Kbij/homecontrol/Arduino/Sensor/Doc/DigiMesh update.docx

DigiMesh update:

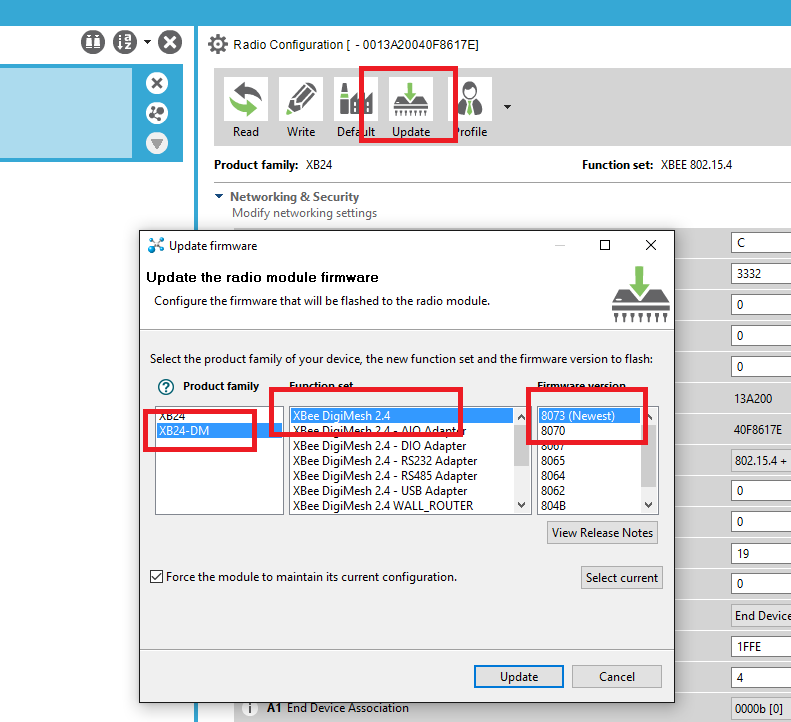
[picture p1: figure]

Write “XBee-DM_ArduinoProfile” profile with XCTU tools
