Kbij/homecontrol/(list of files, cad)

Other CAD files:
Arduino/PCB/Board.skp
Arduino/PCB/MainBoard/Mainboard.skp
Arduino/PCB/TempSensor/Sensor3D.skp
Arduino/PCB/moerhouder.skp
