Kbij/homecontrol/Server/HomeControlTest/testdata/LivingTemperatuur.csv

idTemperature | idSensor | date | temperature
50336 | 2 | 21:49:01 | 23,56
50337 | 2 | 21:49:32 | 23,56
50338 | 2 | 21:50:03 | 23,63
50339 | 2 | 21:50:34 | 23,63
50340 | 2 | 21:51:04 | 23,63
50341 | 2 | 21:53:08 | 23,63
50342 | 2 | 21:56:44 | 23,69
50343 | 2 | 21:57:15 | 23,69
50344 | 2 | 21:58:16 | 23,75
50345 | 2 | 22:07:31 | 23,81
50346 | 2 | 22:08:02 | 23,81
50347 | 2 | 22:08:33 | 23,81
50348 | 2 | 22:09:04 | 23,81
50349 | 2 | 22:09:35 | 23,81
50350 | 2 | 22:10:05 | 23,81
50351 | 2 | 22:10:36 | 23,81
50352 | 2 | 22:11:38 | 23,81
50353 | 2 | 22:12:09 | 23,81
50354 | 2 | 22:12:40 | 23,81
50355 | 2 | 22:13:11 | 23,81
50356 | 2 | 22:13:41 | 23,81
50357 | 2 | 22:14:12 | 23,81
50358 | 2 | 22:14:43 | 23,81
50359 | 2 | 22:15:14 | 23,81
50360 | 2 | 22:15:45 | 23,81
50361 | 2 | 22:16:16 | 23,81
50362 | 2 | 22:16:47 | 23,81
50363 | 2 | 22:17:17 | 23,81
50364 | 2 | 22:17:48 | 23,81
50365 | 2 | 22:18:19 | 23,81
50366 | 2 | 22:25:30 | 23,88
50367 | 2 | 22:26:32 | 23,81
50368 | 2 | 22:27:03 | 23,88
50369 | 2 | 22:27:34 | 23,88
50370 | 2 | 22:29:37 | 23,88
50371 | 2 | 22:30:38 | 23,88
50372 | 2 | 22:31:09 | 23,88
50373 | 2 | 22:31:40 | 23,88
50374 | 2 | 22:42:57 | 23,88
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
