Kbij/homecontrol/Server/HomeControlTest/testdata/LivingTemperatuur2.csv

idTempTemperatures | date | temp
1 | 23:14:23 | 24,13
2 | 23:14:54 | 24
3 | 23:15:25 | 24
4 | 23:15:56 | 24
5 | 23:16:26 | 23,94
6 | 23:16:57 | 23,94
7 | 23:17:28 | 24
8 | 23:17:59 | 24,06
9 | 23:18:30 | 24,13
10 | 23:19:00 | 24,06
11 | 23:19:31 | 24
12 | 23:20:02 | 24
13 | 23:20:33 | 24
14 | 23:21:04 | 23,94
15 | 23:21:34 | 24,06
16 | 23:22:05 | 24
17 | 23:22:36 | 24,06
18 | 23:23:07 | 24
19 | 23:23:38 | 24
20 | 23:24:08 | 24,06
21 | 23:24:39 | 24,06
22 | 23:25:10 | 24
23 | 23:25:41 | 24
24 | 23:26:12 | 24,06
25 | 23:26:42 | 24
26 | 23:27:13 | 24,13
27 | 23:27:44 | 24,06
28 | 23:28:15 | 24
29 | 23:28:46 | 24,13
30 | 23:29:16 | 24,13
31 | 23:29:47 | 24
32 | 23:30:18 | 24,06
33 | 23:30:49 | 24,06
34 | 23:31:20 | 24,13
35 | 23:31:50 | 24,13
36 | 23:32:21 | 24,13
37 | 23:32:52 | 24,06
38 | 23:33:23 | 24
39 | 23:33:54 | 24,13
40 | 23:34:24 | 24,13
41 | 23:34:55 | 24,13
42 | 23:35:26 | 24,06
43 | 23:35:57 | 24,19
44 | 23:36:28 | 24,19
45 | 23:36:58 | 24,13
46 | 23:37:29 | 24,13
47 | 23:38:00 | 24,13
48 | 23:38:31 | 24,19
49 | 23:39:02 | 24,19
50 | 23:39:32 | 24,25
51 | 23:40:03 | 24,13
52 | 23:40:34 | 24,13
53 | 23:41:05 | 24,19
54 | 23:41:36 | 24,19
55 | 23:42:07 | 24,19
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
