Kbij/homecontrol/Arduino/Sensor/Doc/arduino_WirelessShield_Proto_v3-schematic.pdf

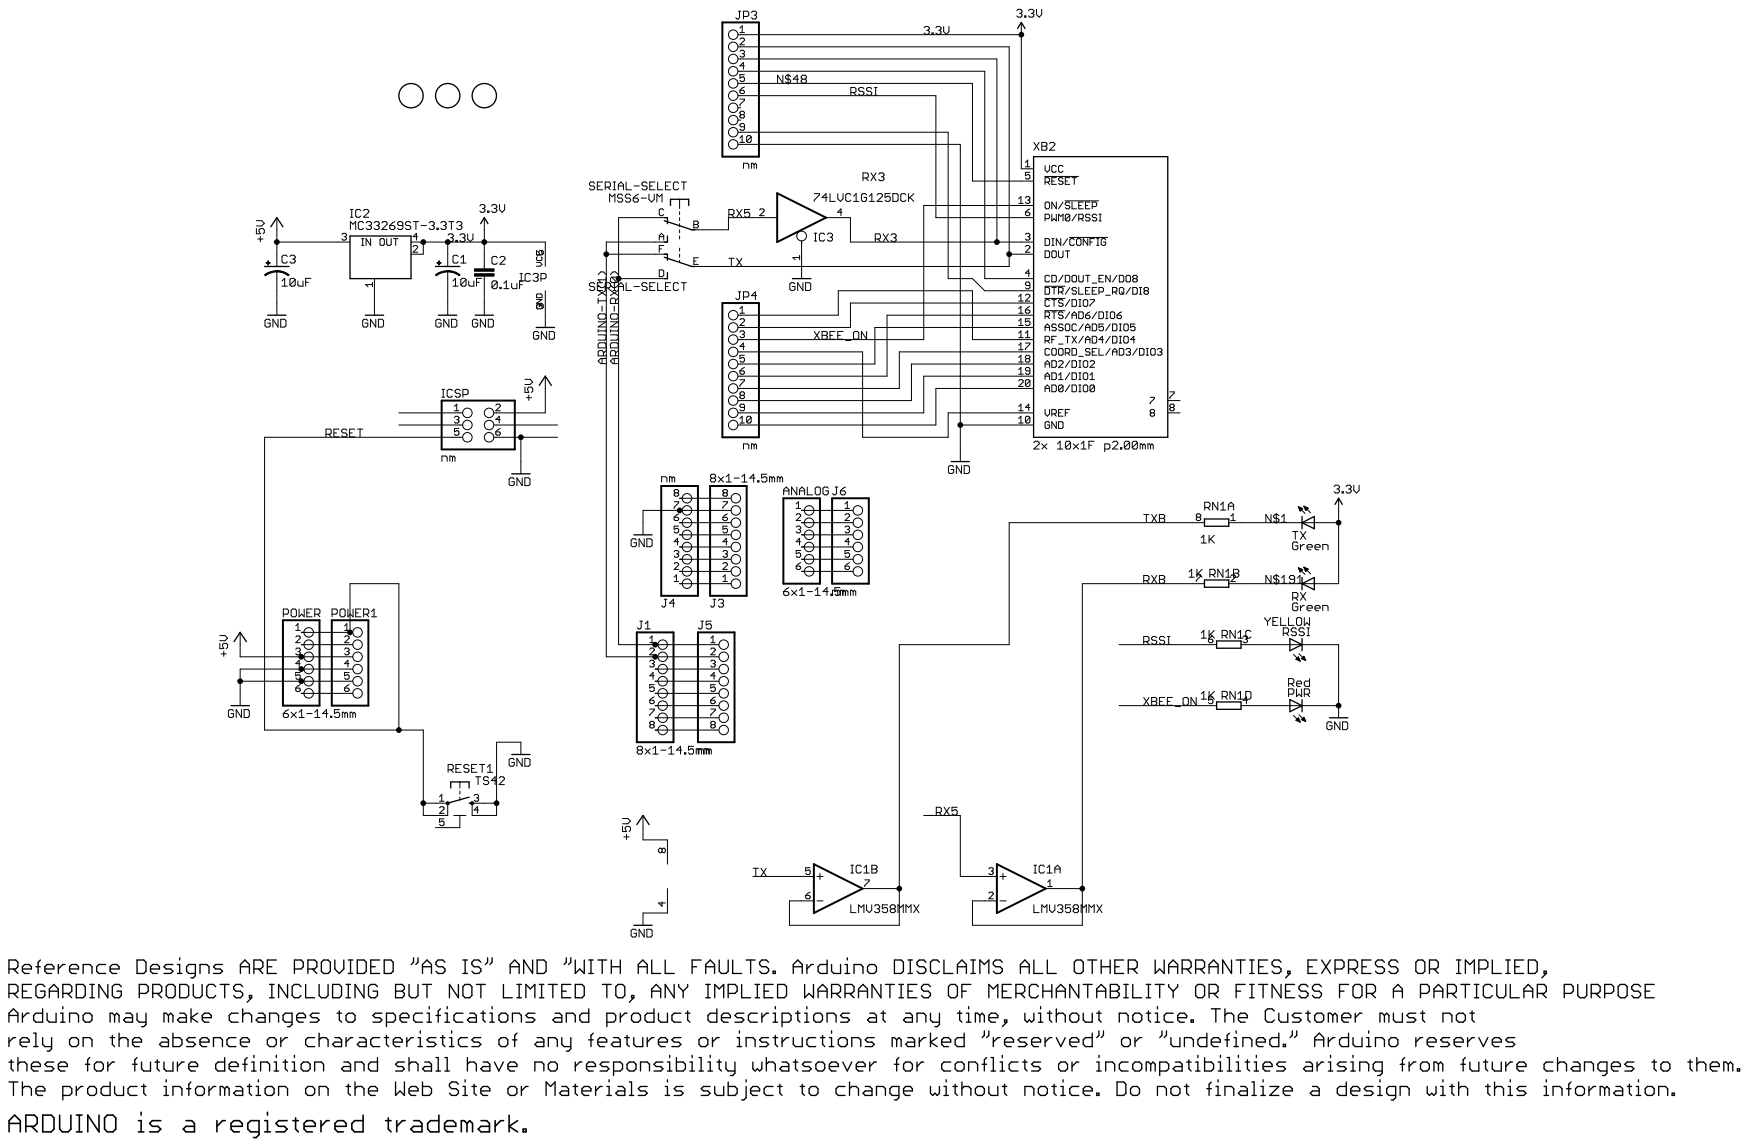
[picture p2: page 1]
