Kbij/homecontrol/Arduino/PCB/MainBoard/Mainboard.brd

## EAGLE design Arduino/PCB/MainBoard/Mainboard.brd (2018-04-23)

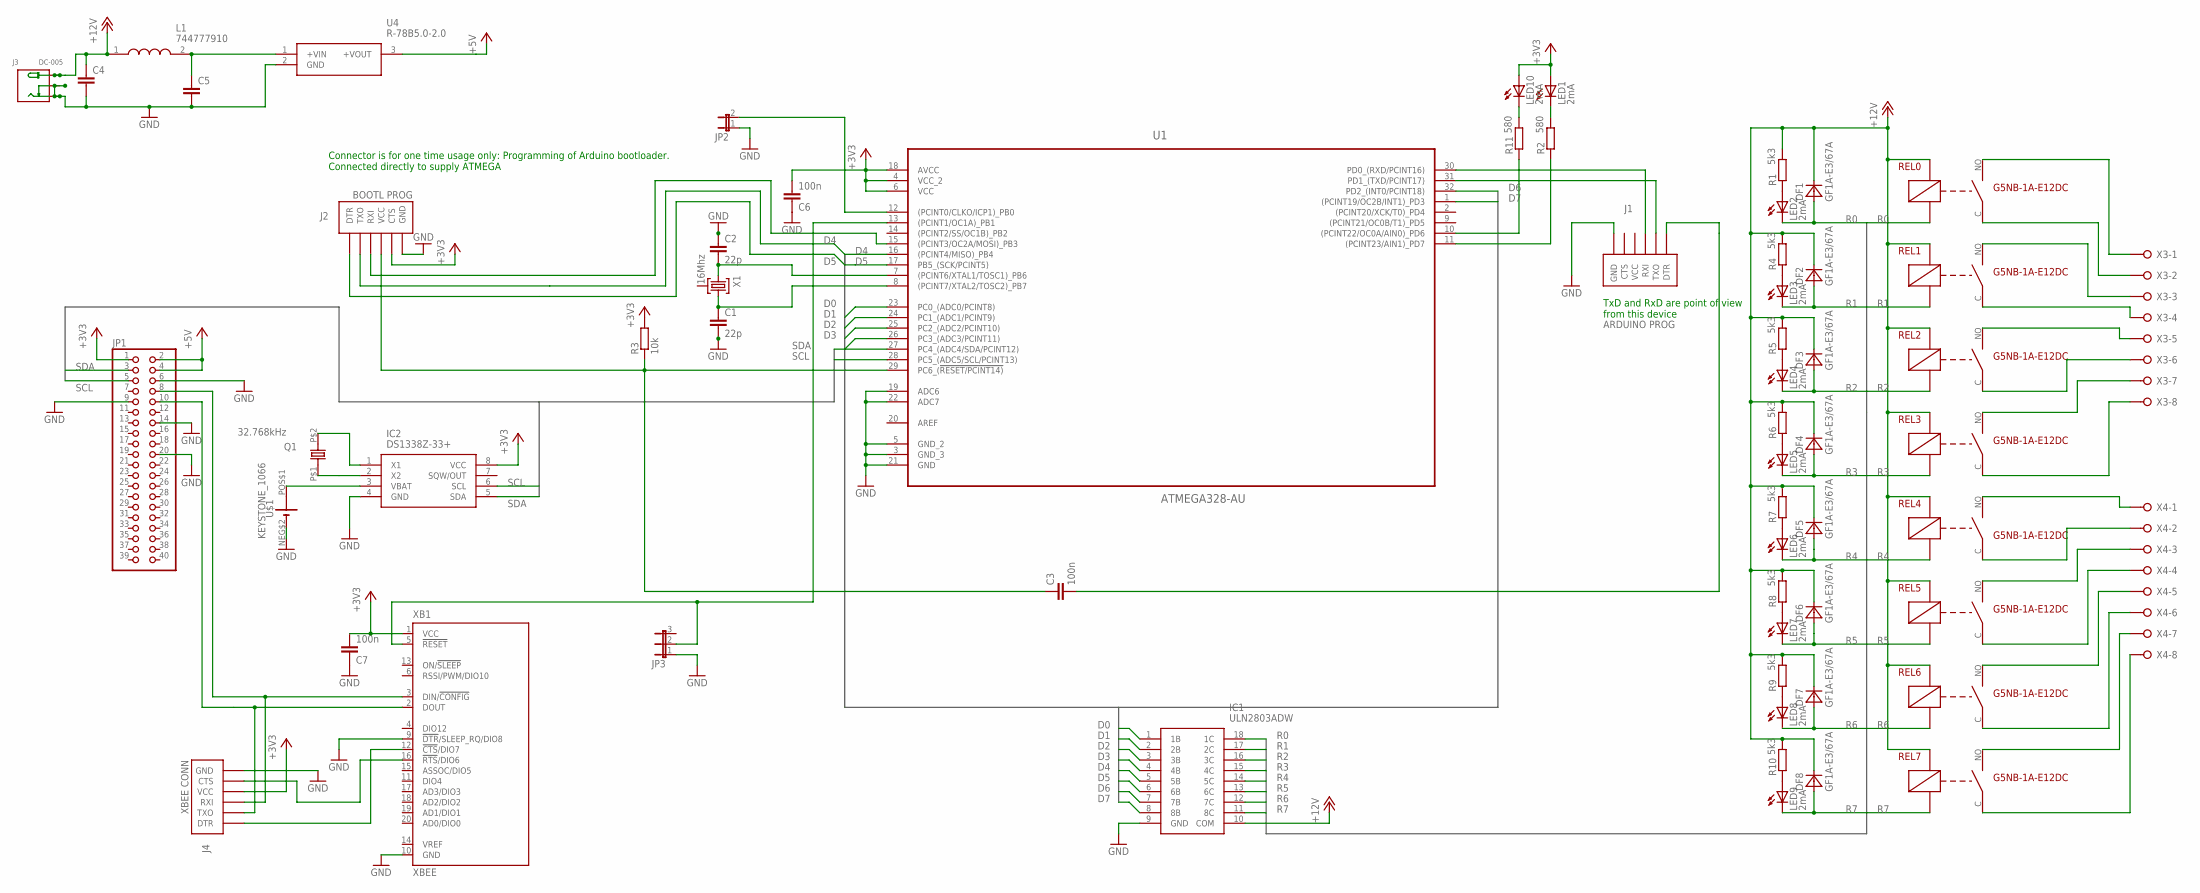
[picture p3: schematic Mainboard.sch]

Parts:
C1, C2: 22p; C0805
C3, C6, C7: 100n; C0805
C4, C5: C-EUC1206; C1206
DF1, DF2, DF3, DF4, DF5, DF6, DF7, DF8: GF1A-E3/67A; DO-214BA
IC1: ULN2803ADW; SOIC127P1030X265-18N
IC2: DS1338Z-33+; SOIC127P600X175-8N
J1: ARDUINO PROG; FTDI_DEVICE_SIDE
J2: BOOTL PROG; FTDI_DEVICE_SIDE
J3: DC-005; DCJ3P-14.2X11.0X9.0MM
J4: XBEE CONN; FTDI_DEVICE_SIDE
JP1: PINHD-2X20; 2X20
JP2: JUMPER_JP1E; JUMPER_JP1
JP3: JP2E; JP2
L1: 744777910; WE-PD_7332/7345_PLASTIC_BASE54
LED1, LED2, LED3, LED4, LED5, LED6, LED7, LED8, LED9, LED10: 2mA; LED3MM
Q1: 32.768kHz; CRYSAL_RADIA_6.2MM
R1, R4, R5, R6, R7, R8, R9, R10: 5k3; R0603
R2, R11: 580; R0603
R3: 10k; R0805
REL0, REL1, REL2, REL3, REL4, REL5, REL6, REL7: G5NB-1A-E12DC; G5NB-1A
U1: ATMEGA328-AU; QFP80P900X900X120-32N
U4: R-78B5.0-2.0; R-78B5
U$1: KEYSTONE_1066; KEYSTONE1066
X1: 16Mhz; HC49-3L; MPN LFXTAL003240
X3, X4: W237-08P; W237-8P
XB1: XBEE

Connections:
+3V3: C6.2, C7.2, IC2.8 (VCC), J2.P$5 (CTS), J4.P$4 (VCC), JP1.1, LED1.A, LED10.A, R3.2, U1.4 (VCC_2), U1.6 (VCC), U1.18 (AVCC), XB1.1 (VCC)
+5V: JP1.2, JP1.4, U4.3 (+VOUT)
+12V: C4.1, DF1.C, DF2.C, DF3.C, DF4.C, DF5.C, DF6.C, DF7.C, DF8.C, IC1.10 (COM), J3.+, L1.1, R1.2, R4.2, R5.2, R6.2, R7.2, R8.2, R9.2, R10.2, REL0.A1, REL1.A1, REL2.A1, REL3.A1, REL4.A1, REL5.A1, REL6.A1, REL7.A1
D0: IC1.1 (1B), U1.23 (PC0_(ADC0/PCINT8))
D1: IC1.2 (2B), U1.24 (PC1_(ADC1/PCINT9))
D2: IC1.3 (3B), U1.25 (PC2_(ADC2/PCINT10))
D3: IC1.4 (4B), U1.26 (PC3_(ADC3/PCINT11))
D4: IC1.5 (5B), J2.P$2 (TXO), U1.16 ((PCINT4/MISO)_PB4)
D5: IC1.6 (6B), J2.P$1 (DTR), U1.17 (PB5_(SCK/PCINT5))
D6: IC1.7 (7B), U1.32 (PD2_(INT0/PCINT18))
D7: IC1.8 (8B), U1.1 ((PCINT19/OC2B/INT1)_PD3)
GND: C1.2, C2.1, C4.2, C5.2, C6.1, C7.1, IC1.9 (GND), IC2.4 (GND), J1.P$6 (GND), J2.P$6 (GND), J3.-1 (-), J4.P$6 (GND), JP1.6, JP1.9, JP1.14, JP1.20, JP2.1, JP3.1, U1.3 (GND_3), U1.5 (GND_2), U1.19 (ADC6), U1.21 (GND), U1.22 (ADC7), U4.2 (GND), U$1.NEG$2 (-), XB1.9 (!DTR!/SLEEP_RQ/DIO8), XB1.10 (GND)
unnamed: C2.2, U1.7 ((PCINT6/XTAL1/TOSC1)_PB6), X1.1
unnamed: JP3.2, U1.13 ((PCINT1/OC1A)_PB1), XB1.5 (!RESET)
unnamed: J4.P$2 (TXO), JP1.10, XB1.2 (DOUT)
unnamed: REL0.NO, X3.1
unnamed: C3.2, J1.P$1 (DTR)
unnamed: C1.1, U1.8 ((PCINT7/XTAL2/TOSC2)_PB7), X1.3
unnamed: C5.1, L1.2, U4.1 (+VIN)
unnamed: R2.1, U1.11 ((PCINT23/AIN1)_PD7)
unnamed: J1.P$3 (RXI), U1.30 (PD0_(RXD/PCINT16))
unnamed: J1.P$2 (TXO), U1.31 (PD1_(TXD/PCINT17))
unnamed: LED1.K (C), R2.2
unnamed: IC2.3 (VBAT), U$1.POS$1 (+)
unnamed: J4.P$1 (DTR), XB1.12 (!CTS!/DIO7)
unnamed: IC2.2 (X2), Q1.P$1 (1)
unnamed: REL0.C, X3.2
unnamed: REL1.NO, X3.3
unnamed: REL1.C, X3.4
unnamed: REL2.NO, X3.5
unnamed: REL2.C, X3.6
unnamed: C3.1, J2.P$4 (VCC), R3.1, U1.29 (PC6_(!RESET/PCINT14))
unnamed: REL3.NO, X3.7
unnamed: J2.P$3 (RXI), U1.15 ((PCINT3/OC2A/MOSI)_PB3)
unnamed: REL7.NO, X4.7
unnamed: LED10.K (C), R11.2
unnamed: REL3.C, X3.8
unnamed: REL4.NO, X4.1
unnamed: REL4.C, X4.2
unnamed: REL5.NO, X4.3
unnamed: REL5.C, X4.4
unnamed: REL6.NO, X4.5
unnamed: REL6.C, X4.6
unnamed: REL7.C, X4.8
unnamed: JP2.2, U1.12 ((PCINT0/CLKO/ICP1)_PB0)
unnamed: J4.P$3 (RXI), JP1.8, XB1.3 (DIN/!CONFIG)
unnamed: LED2.A, R1.1
unnamed: LED3.A, R4.1
unnamed: LED4.A, R5.1
unnamed: LED5.A, R6.1
unnamed: LED7.A, R8.1
unnamed: IC2.1 (X1), Q1.P$2 (2)
unnamed: J4.P$5 (CTS), XB1.16 (!RTS!/DIO6)
unnamed: LED6.A, R7.1
unnamed: R11.1, U1.10 ((PCINT22/OC0A/AIN0)_PD6)
unnamed: LED8.A, R9.1
unnamed: LED9.A, R10.1
R0: DF1.A, IC1.18 (1C), LED2.K (C), REL0.A2
R1: DF2.A, IC1.17 (2C), LED3.K (C), REL1.A2
R2: DF3.A, IC1.16 (3C), LED4.K (C), REL2.A2
R3: DF4.A, IC1.15 (4C), LED5.K (C), REL3.A2
R4: DF5.A, IC1.14 (5C), LED6.K (C), REL4.A2
R5: DF6.A, IC1.13 (6C), LED7.K (C), REL5.A2
R6: DF7.A, IC1.12 (7C), LED8.K (C), REL6.A2
R7: DF8.A, IC1.11 (8C), LED9.K (C), REL7.A2
SCL: IC2.6 (SCL), JP1.5, U1.28 (PC5_(ADC5/SCL/PCINT13))
SDA: IC2.5 (SDA), JP1.3, U1.27 (PC4_(ADC4/SDA/PCINT12))

Notes on the sheet:
Connector is for one time usage only: Programming of Arduino bootloader. Connected directly to supply ATMEGA
TxD and RxD are point of view from this device

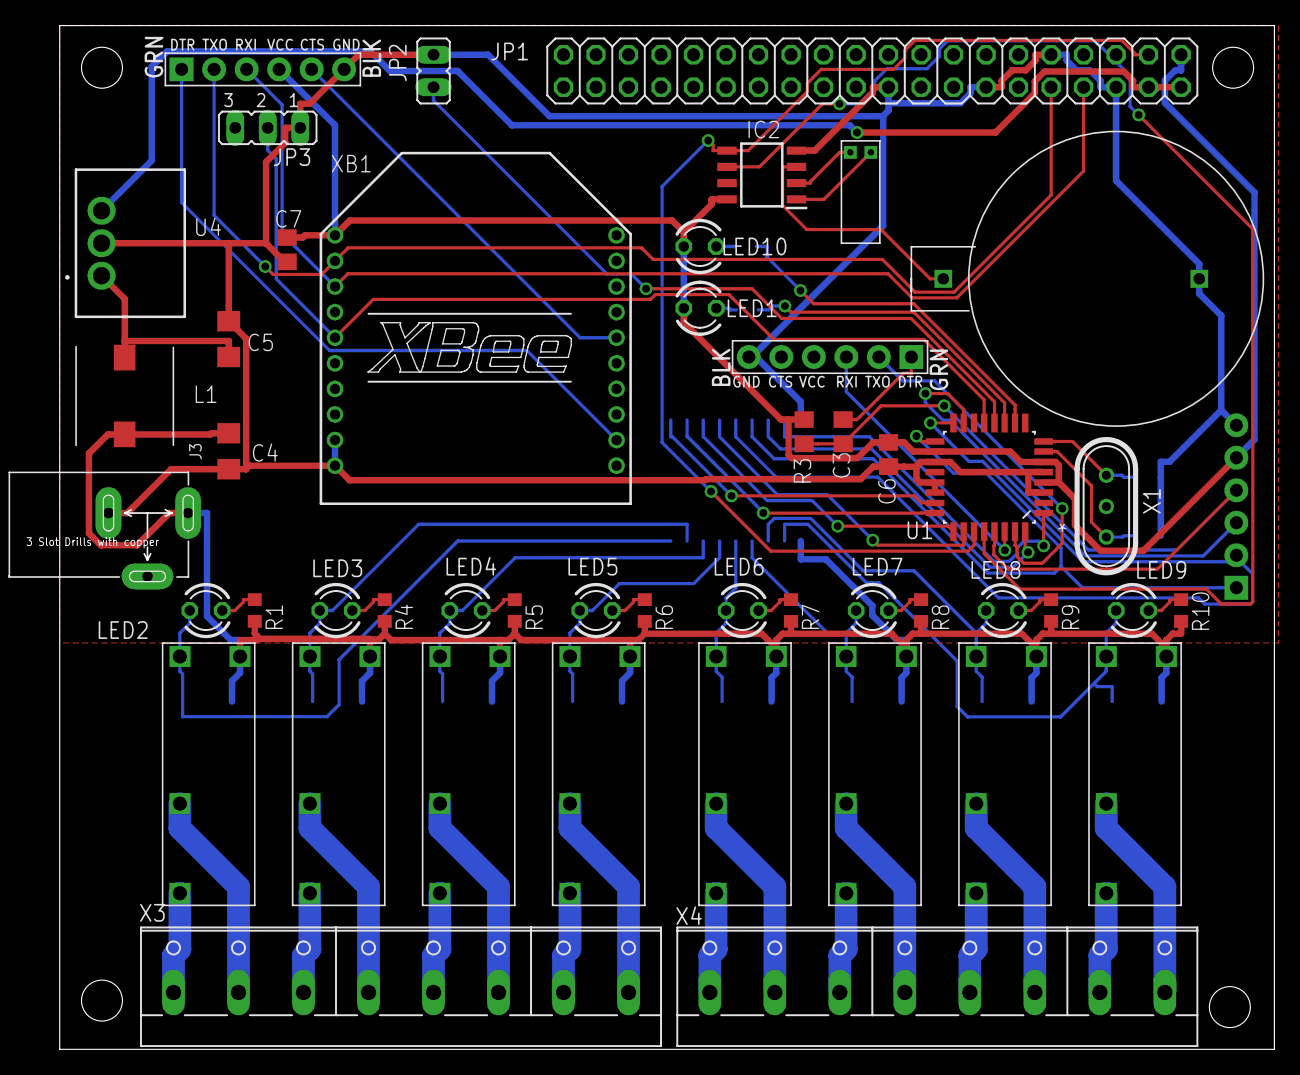
[picture p4: board Mainboard.brd from above]

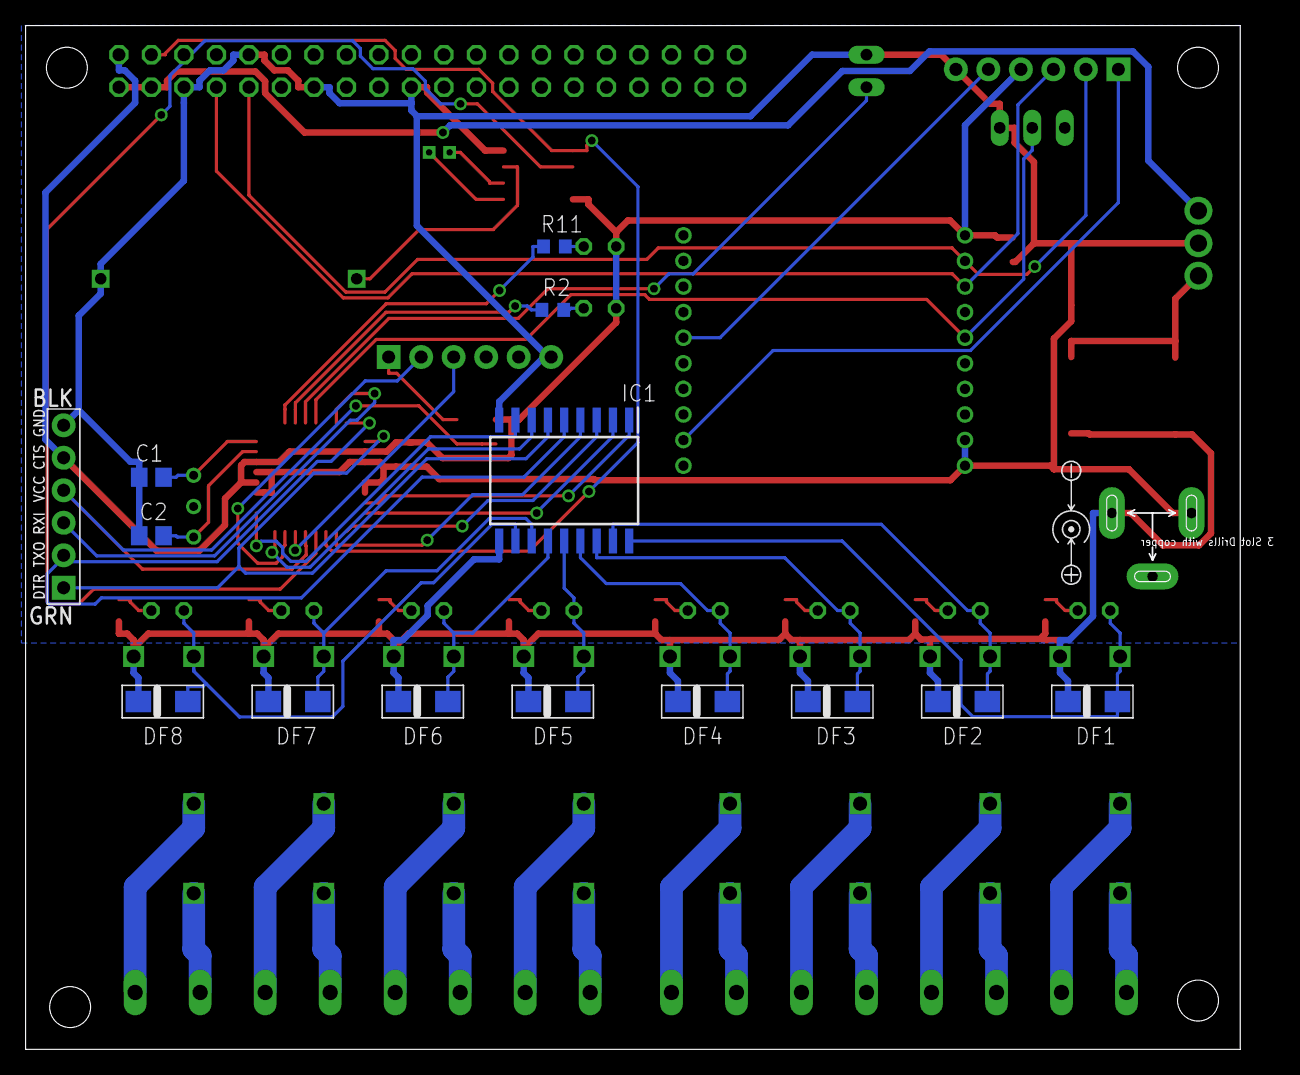
[picture p5: board Mainboard.brd from below]

Board: 2 copper layers, 94.9 x 80.0 mm, 62 parts (14 on the bottom side), 67 nets.
