Kbij/homecontrol/Arduino/PCB/TempSensor/TempSensor.brd

## EAGLE design Arduino/PCB/TempSensor/TempSensor.brd (2017-03-12)

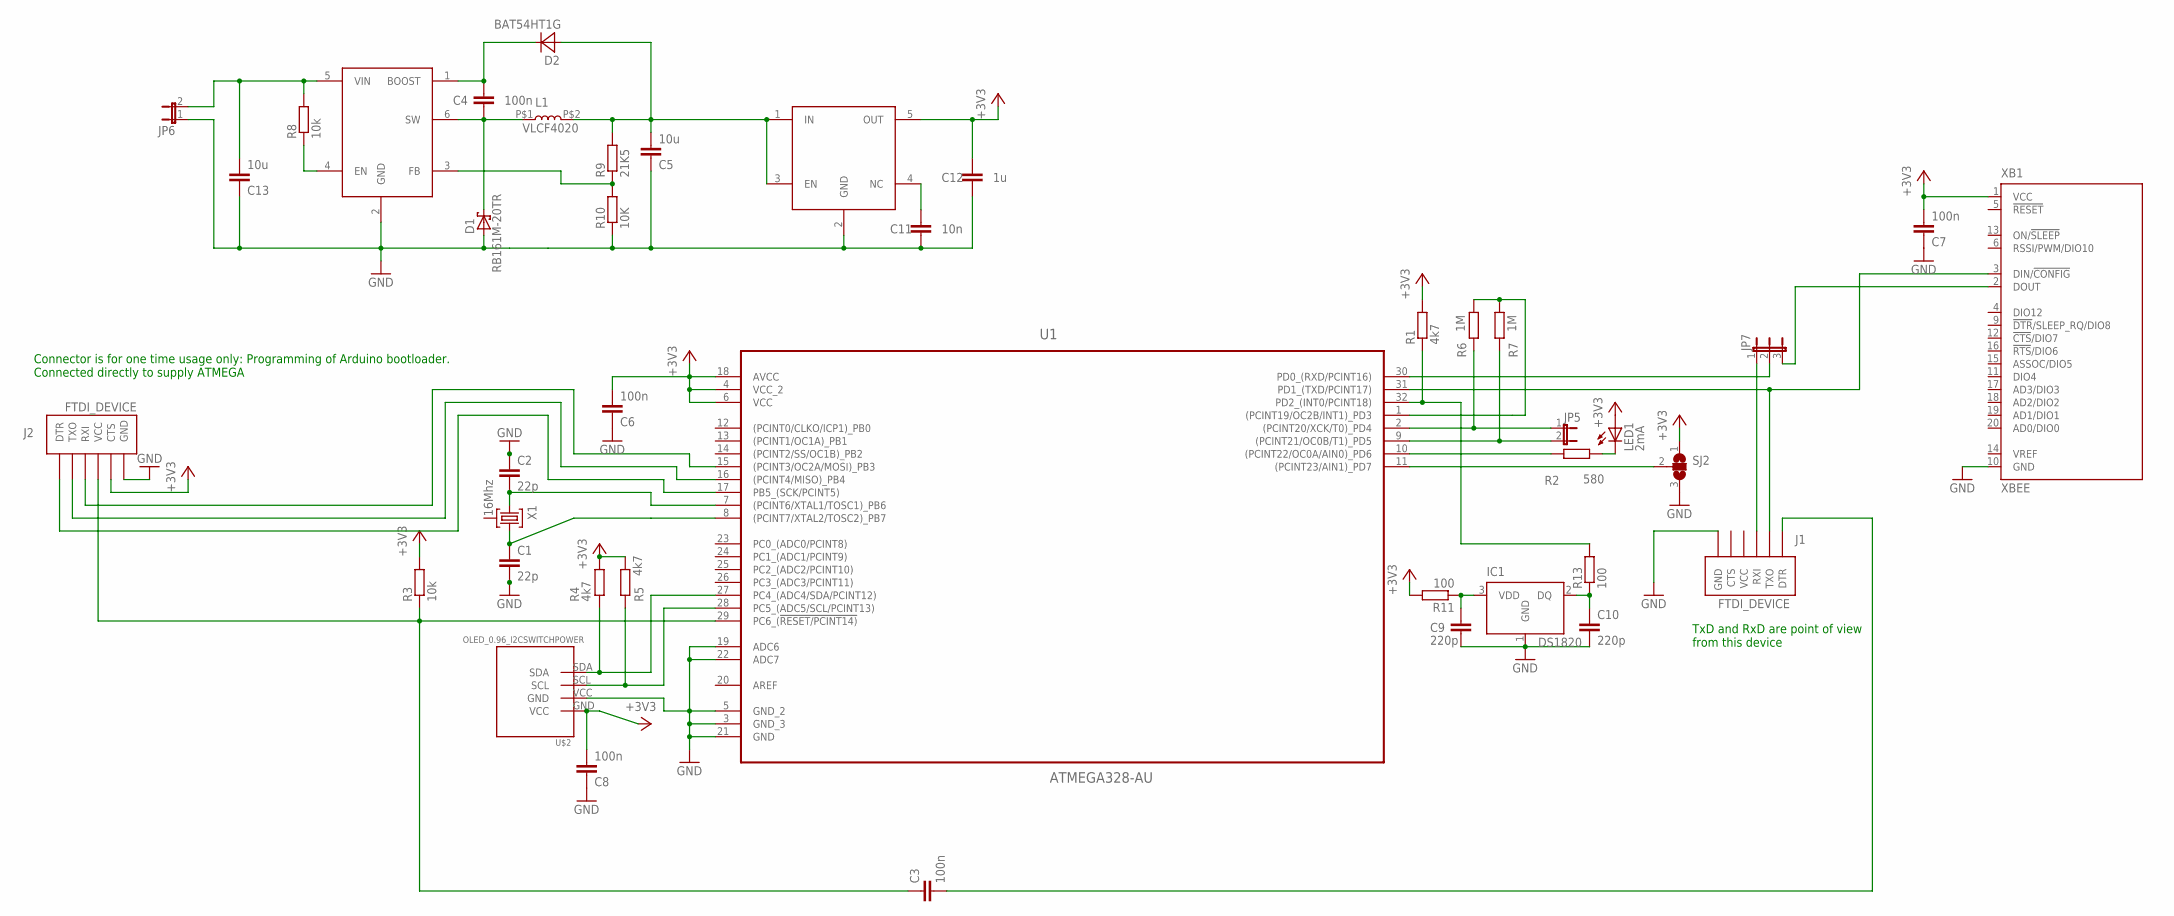
[picture p6: schematic TempSensor.sch]

Parts:
C1, C2: 22p; C0805
C3, C4, C6, C7, C8: 100n; C0805
C5, C13: 10u; C0805
C9, C10: 220p; C0805
C11: 10n; C0805
C12: 1u; C0805
D1: RB161M-20TR; SOD123
D2: BAT54HT1G; SOD323_ST
IC1: DS1820; TO-92
J1, J2: FTDI_DEVICE; FTDI_DEVICE_SIDE
JP5, JP6: JP1E; JP1
JP7: JP2E; JP2
L1: VLCF4020
LED1: 2mA; LED3MM
R1, R4, R5: 4k7; R0805
R2: 580; R0603
R3, R8: 10k; R0805
R6, R7: 1M; R0805
R9: 21K5; R0805
R10: 10K; R0805
R11, R13: 100; R0805
SJ2: SJ2W; SJ_2
U1: ATMEGA328-AU; QFP80P900X900X120-32N
U2: LM2736X; SOT23-6L
U3: XC6210; SOT23-5
U$2: OLED_0.96_I2CSWITCHPOWER; OLED_0.96_I2C
X1: 16Mhz; HC49-3L; MPN LFXTAL003240
XB1: XBEE

Connections:
+3V3: C6.2, C7.2, C8.2, C12.2, J2.P$5 (CTS), LED1.A, R1.2, R3.2, R4.2, R5.2, R11.2, SJ2.1, U1.4 (VCC_2), U1.6 (VCC), U1.18 (AVCC), U3.5 (OUT), U$2.GND (VCC), XB1.1 (VCC)
GND: C1.2, C2.1, C5.1, C6.1, C7.1, C8.1, C9.1, C10.1, C11.1, C12.1, C13.1, D1.A, IC1.1 (GND), J1.P$6 (GND), J2.P$6 (GND), JP6.1, R10.1, SJ2.3, U1.3 (GND_3), U1.5 (GND_2), U1.19 (ADC6), U1.21 (GND), U1.22 (ADC7), U2.2 (GND), U3.2 (GND), U$2.VCC (GND), XB1.10 (GND)
unnamed: C2.2, U1.7 ((PCINT6/XTAL1/TOSC1)_PB6), X1.1
unnamed: C1.1, U1.8 ((PCINT7/XTAL2/TOSC2)_PB7), X1.3
unnamed: J1.P$3 (RXI), JP7.1
unnamed: JP7.2, U1.30 (PD0_(RXD/PCINT16))
unnamed: J1.P$2 (TXO), U1.31 (PD1_(TXD/PCINT17)), XB1.3 (DIN/!CONFIG)
unnamed: R1.1, R13.2, U1.32 (PD2_(INT0/PCINT18))
unnamed: R6.2, R7.2, U1.1 ((PCINT19/OC2B/INT1)_PD3)
unnamed: C4.1, D1.C, L1.P$1 (1), U2.6 (SW)
unnamed: JP5.1, R6.1, U1.2 ((PCINT20/XCK/T0)_PD4)
unnamed: JP5.2, R7.1, U1.9 ((PCINT21/OC0B/T1)_PD5)
unnamed: R9.1, R10.2, U2.3 (FB)
unnamed: LED1.K (C), R2.2
unnamed: R2.1, U1.10 ((PCINT22/OC0A/AIN0)_PD6)
unnamed: SJ2.2, U1.11 ((PCINT23/AIN1)_PD7)
unnamed: JP7.3, XB1.2 (DOUT)
unnamed: C4.2, D2.C, U2.1 (BOOST)
unnamed: C3.1, J2.P$4 (VCC), R3.1, U1.29 (PC6_(!RESET/PCINT14))
unnamed: C3.2, J1.P$1 (DTR)
unnamed: J2.P$3 (RXI), U1.15 ((PCINT3/OC2A/MOSI)_PB3)
unnamed: J2.P$1 (DTR), U1.17 (PB5_(SCK/PCINT5))
unnamed: J2.P$2 (TXO), U1.16 ((PCINT4/MISO)_PB4)
unnamed: R8.1, U2.4 (EN)
unnamed: C9.2, IC1.3 (VDD), R11.1
unnamed: C10.2, IC1.2 (DQ), R13.1
unnamed: C11.2, U3.4 (NC)
SCL: R5.1, U1.28 (PC5_(ADC5/SCL/PCINT13)), U$2.SCL
SDA: R4.1, U1.27 (PC4_(ADC4/SDA/PCINT12)), U$2.SDA
VIN: C13.2, JP6.2, R8.2, U2.5 (VIN)
VO: C5.2, D2.A, L1.P$2 (2), R9.2, U3.1 (IN), U3.3 (EN)

Notes on the sheet:
Connector is for one time usage only: Programming of Arduino bootloader. Connected directly to supply ATMEGA
TxD and RxD are point of view from this device

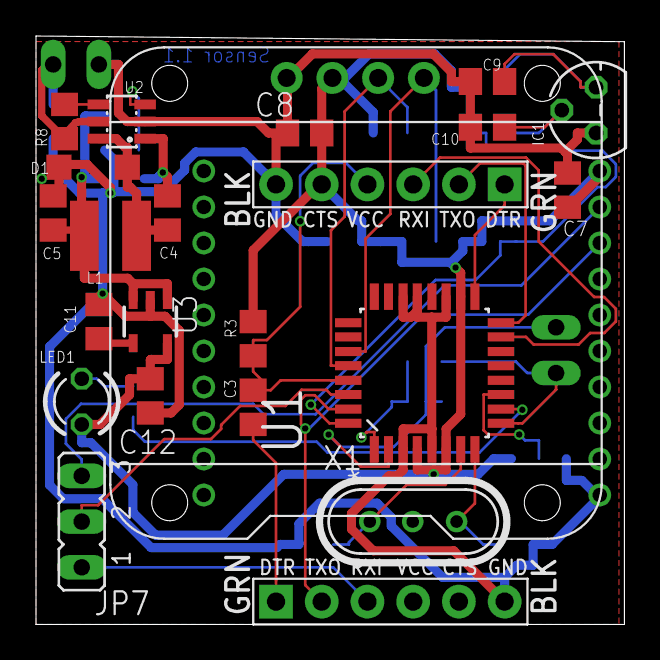
[picture p7: board TempSensor.brd from above]

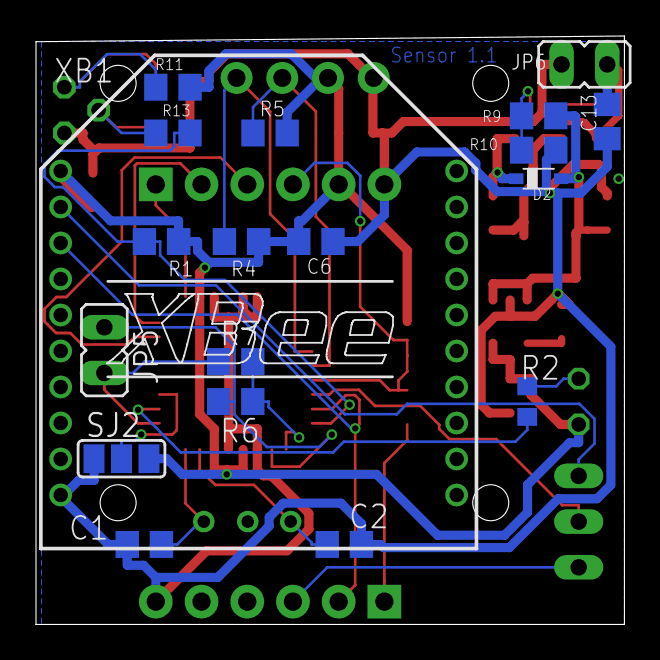
[picture p8: board TempSensor.brd from below]

Board: 2 copper layers, 32.7 x 32.7 mm, 42 parts (19 on the bottom side), 31 nets.
