Kbij/homecontrol/Server/HomeControlTest/src/MainTest.cpp

/*
 * MainTest.cpp
 *
 *  Created on: Mar 28, 2016
 *      Author: koen
 */

#include "gtest/gtest.h"
#include <glog/logging.h>
#include <gflags/gflags.h>

DEFINE_bool(server, false, "Run live test as Server");
DEFINE_bool(client, false, "Run live test as Client");

GTEST_API_ int main(int argc, char **argv)
{
	google::SetVersionString("1.0.0");
	google::ParseCommandLineFlags(&argc, &argv, true);

	google::InitGoogleLogging("Home Control Test");
	testing::InitGoogleTest(&argc, argv);
	testing::GTEST_FLAG(filter) = "-LiveTest.*";


//	testing::GTEST_FLAG(filter) = "CommRouter.SendTemperatureToCommServer";
	testing::GTEST_FLAG(filter) = "QueryDecodeTest.*";


	if (FLAGS_server)
	{
		testing::GTEST_FLAG(filter) = "LiveTest.TempSensorsServer";
	}
	if (FLAGS_client)
	{
		testing::GTEST_FLAG(filter) = "LiveTest.Client";
	}

	FLAGS_logtostderr=1;
//	FLAGS_v = 3;

	//FLAGS_minloglevel = 100;
    int result = RUN_ALL_TESTS();

	google::ShutdownGoogleLogging();
	google::ShutDownCommandLineFlags();
	return result;
}
