Kbij/homecontrol/(commit log)

2016-04-23 CommModel Maintenance thread, Cloudsocket
2016-05-17 socket and various other, still not working
2016-05-17 sql create tables
    [CreateTable2.sql.csv, CreateTable3.sql.csv]
2016-05-28 arduino first commit
2016-05-31 write temperature to db
2016-06-01 LPF filter
2016-06-01 adding filter
2016-06-02 moving verage filter
2016-06-03 insert new sensor
2016-06-12 temperature monitoring
2016-06-13 mem leaks + mysql threadinit threadend
    [Client.cpp, MainApp.cpp, ObjectWriter.cpp, Server.cpp, ServerSocket.cpp]
2016-06-14 fix test & build info
    [Client.cpp, MainApp.cpp]
2016-06-14 new test data
    [LivingTemperatuur.csv]
2016-06-16 filter startup
2016-06-18 double in temperature filter& logging
2016-07-07 frame processor + tests
2016-07-08 added frame processor
2016-08-06 Arduino code
2016-10-03 fix mem leaks in tests + fix hang
    [CommRouterTest.cpp, MainTest.cpp, TemperatureSensorsTest.cpp]
2016-10-29 unfirtered temperature logging
2016-11-06 sensor pcb
    [Board.skp, TempSensor.brd, TempSensor.sch]
2016-11-07 log without filtering
2016-11-07 filter, round less
2016-11-11 weighted exponential filter
2016-11-13 send calibration
2016-11-13 temperature viewer
2016-11-13 Board as send
    [Board.skp, TempSensor.brd]
2016-11-13 Filter + Calibration
2016-11-22 set sensor resolution
2016-11-23 fix filter
2016-11-27 send roomName to sensor
2017-01-04 base board
    [TempSensor.brd, TempSensor.sch]
2017-01-10 Voor aanpassing board (verplaatsen toetsen en xbee)
    [TempSensor.brd, TempSensor.sch]
2017-01-11 met manuele routing power
    [TempSensor.brd]
2017-01-13 xbee/oled positie + power routed
    [TempSensor.brd]
2017-01-13 power routed
    [TempSensor.brd]
2017-01-16 power routed/ labels placed
    [TempSensor.brd, TempSensor.sch]
2017-01-16 input cap toegevoegd
    [TempSensor.brd, TempSensor.sch]
2017-01-26 sensor changes
2017-01-28 as Send to allpcb
    [Sensor3D.skp, TempSensor.brd]
2017-01-30 Set temperature up/down
2017-03-05 component values
    [TempSensor.brd, TempSensor.sch]
2017-03-12 part values
    [TempSensor.brd, TempSensor.sch]
2018-04-02 write time to sensors
2018-04-02 Receive time & enable up/down buttons
2018-04-14 working, not interrupt safe
2018-04-20 ready to send v2
    [Mainboard.brd, Mainboard.sch]
2018-05-12 lastest board version
2018-12-26 log battery level
2019-01-12 fix crash tcp server
    [Client.cpp, ClientSocket.cpp, ServerSocket.cpp]
2019-01-12 send battery level
2019-01-12 support for location interval and battery level
2019-01-13 heater logging
2019-01-13 write heater state
2019-01-14 send heater on/off
2019-01-14 heater feedback working
2019-02-11 async socket + other
2020-01-10 compiles, exclude capacitive sensors
2020-01-12 added FilteredTemperatureSensor
2020-01-12 incl temperature sensor (not working)
    [FilteredTemperatureSensor.h, SensorDisplay.cpp, SensorDisplay.h, main.cpp]
2021-10-12 - new server - filter location - filter location unit test
2022-11-19 - fix shared_ptr issue, added mutex
    [Client.cpp, ClientSocket.cpp, HomeControlDalTest.cpp, MainTest.cpp, ObjectWriter.cpp, ServerSocket.cpp]
2023-04-11 -fix haning sockets
2026-09-06 - mysql driver
2026-11-09 - fix server tcp thread stopping when client disconnects during accept
2026-11-09 - add self-learning pid thermostat with json gain storage
2026-11-09 - upgrade desktop projects to .net framework 4.8
